RollMan/moxiao/(commit log)

2026-11-07 wip: remove redundant capacitors
    [hpamp_combo.kicad_pcb, hpamp_combo.kicad_sch]
2026-11-07 complete 1st release
    [hpamp_combo.kicad_pcb, hpamp_combo.kicad_sch]
